BTFLV/PROE_WGR-V/rtl/peripherals/ws2812b.v

`include "../defines.v"
`default_nettype none
`timescale 1ns / 1ns

/**
 * @brief Treibermodul für WS2812B-LEDs (NeoPixel).
 *
 * Dieses Modul steuert eine Kette von WS2812B-LEDs. Es werden nacheinander
 * 24-Bit-Farbwerte (GRB) an die LEDs gesendet. Die Zeitsteuerung erfolgt
 * über entsprechende Zähler (T0H, T0L, T1H, T1L, T_RESET). Dieses Beispiel
 * zeigt eine einfache State-Maschine, die die Daten nacheinander an jede LED
 * überträgt, dann ein Reset-Puls erzeugt und wieder von vorne beginnt.
 *
 * Register-Offsets (jeweils 8 Bit auseinanderliegend):
 * - 0x00: Daten für LED 0
 * - 0x04: Daten für LED 1
 * - 0x08: Daten für LED 2
 * - 0x0C: Daten für LED 3
 * - 0x10: Daten für LED 4
 * - 0x14: Daten für LED 5
 * - 0x18: Daten für LED 6
 * - 0x1C: Daten für LED 7
 *
 * @localparam CLK_PERIOD_NS Zeit pro Takt in Nanosekunden, abgeleitet aus `CLK_FREQ`.
 * @localparam T0H           Länger des "High" bei Bit=0
 * @localparam T0L           Länger des "Low" bei Bit=0
 * @localparam T1H           Länger des "High" bei Bit=1
 * @localparam T1L           Länger des "Low" bei Bit=1
 * @localparam T_RESET       Pause, damit die LED-Kette den Frame erkennt
 *
 * @localparam STATE_LOAD_LED  Initialer Zustand zum Laden der LED-Daten
 * @localparam STATE_SEND_HIGH Sendephase: Leitung auf High
 * @localparam STATE_SEND_LOW  Sendephase: Leitung auf Low
 * @localparam STATE_RESET     Reset-Pause nach allen Bits
 *
 * @input  clk               Systemtakt
 * @input  rst_n             Asynchroner, aktiver-LOW Reset
 * @input  [7:0]  address    Adressoffset, um eine der 8 LED-Daten zu wählen
 * @input  [31:0] write_data Zu schreibender RGB-Wert (24 Bit genutzt)
 * @output [31:0] read_data  Gibt den gespeicherten RGB-Wert zurück
 * @input  we                Write Enable zum Setzen von LED-Farbwerten
 * @input  re                Read Enable zum Auslesen gespeicherter Werte
 *
 * @output reg  ws_out       Ausgangssignal zur WS2812B-Datenleitung
 */

module ws2812b (
  input  wire         clk,
  input  wire         rst_n,
  input  wire  [ 7:0] address,
  input  wire  [31:0] write_data,
  output wire  [31:0] read_data,
  input  wire         we,
  input  wire         re,
  output reg          ws_out
);

  // ---------------------------------------------------------
  // Ermitteln der Taktperiode in Nanosekunden basierend auf CLK_FREQ.
  // Werte T0H, T0L, T1H, T1L, T_RESET werden gerundet (IntegerDivision).
  // ---------------------------------------------------------
  localparam CLK_PERIOD_NS = 1_000_000_000 / `CLK_FREQ;
  localparam T0H     = (400 + CLK_PERIOD_NS - 1) / CLK_PERIOD_NS;
  localparam T0L     = (850 + CLK_PERIOD_NS - 1) / CLK_PERIOD_NS;
  localparam T1H     = (800 + CLK_PERIOD_NS - 1) / CLK_PERIOD_NS;
  localparam T1L     = (450 + CLK_PERIOD_NS - 1) / CLK_PERIOD_NS;
  localparam T_RESET = (50_000 + CLK_PERIOD_NS - 1) / CLK_PERIOD_NS;

  // ---------------------------------------------------------
  // Zustandsdefinitionen
  // ---------------------------------------------------------
  localparam STATE_LOAD_LED   = 2'd0;
  localparam STATE_SEND_HIGH  = 2'd1;
  localparam STATE_SEND_LOW   = 2'd2;
  localparam STATE_RESET      = 2'd3;

  // ---------------------------------------------------------
  // LED-Daten: 8 LEDs à 24 Bit RGB
  // - led_rgb[i] ist ein 24-Bit-Wert, repräsentiert G,R,B
  // - Schieberegister shift_reg zum Senden
  // ---------------------------------------------------------
  reg [23:0] led_rgb [0:7];
  reg [23:0] shift_reg;
  reg [15:0] timer;
  reg [ 4:0] bit_index;
  reg [ 2:0] led_index;
  reg [ 1:0] state;

  // ---------------------------------------------------------
  // Lese-Multiplexer: Bei Adressen 0x00, 0x04, 0x08, ... 0x1C
  // wird der entsprechende led_rgb[i]-Wert (24 Bit) zurückgegeben.
  // Die oberen 8 Bit von read_data bleiben 0.
  // ---------------------------------------------------------
  assign read_data = (address[7:0] == 8'h00) ? {8'b0, led_rgb[0]} :
                     (address[7:0] == 8'h04) ? {8'b0, led_rgb[1]} :
                     (address[7:0] == 8'h08) ? {8'b0, led_rgb[2]} :
                     (address[7:0] == 8'h0C) ? {8'b0, led_rgb[3]} :
                     (address[7:0] == 8'h10) ? {8'b0, led_rgb[4]} :
                     (address[7:0] == 8'h14) ? {8'b0, led_rgb[5]} :
                     (address[7:0] == 8'h18) ? {8'b0, led_rgb[6]} :
                     (address[7:0] == 8'h1C) ? {8'b0, led_rgb[7]} :
                     32'd0;

  // ---------------------------------------------------------
  // Schreiben in die LED-Register
  // - address = 0x00, 0x04, ... => speichert 24 Bit in led_rgb
  // ---------------------------------------------------------
  always @(posedge clk or negedge rst_n)
  begin
    if (!rst_n) 
    begin
      led_rgb[0] <= 24'h0;
      led_rgb[1] <= 24'h0;
      led_rgb[2] <= 24'h0;
      led_rgb[3] <= 24'h0;
      led_rgb[4] <= 24'h0;
      led_rgb[5] <= 24'h0;
      led_rgb[6] <= 24'h0;
      led_rgb[7] <= 24'h0;
    end 
    else if (we) 
    begin
      case(address)
        8'h00: led_rgb[0] <= write_data[23:0];
        8'h04: led_rgb[1] <= write_data[23:0];
        8'h08: led_rgb[2] <= write_data[23:0];
        8'h0C: led_rgb[3] <= write_data[23:0];
        8'h10: led_rgb[4] <= write_data[23:0];
        8'h14: led_rgb[5] <= write_data[23:0];
        8'h18: led_rgb[6] <= write_data[23:0];
        8'h1C: led_rgb[7] <= write_data[23:0];
        default: ;
      endcase
    end
  end

  // ---------------------------------------------------------
  // Haupt-Zustandsmaschine:
  // 1) STATE_LOAD_LED: Lade Daten der aktuellen LED in shift_reg.
  // 2) STATE_SEND_HIGH: Sende "High"-Phase (T0H oder T1H).
  // 3) STATE_SEND_LOW:  Sende "Low"-Phase  (T0L oder T1L).
  // 4) STATE_RESET:     Nach allen Bits die Resetlücke (T_RESET).
  // ---------------------------------------------------------
  always @(posedge clk or negedge rst_n)
  begin
    if (!rst_n)
    begin
      state     <= STATE_LOAD_LED;
      led_index <= 3'd0;
      bit_index <= 5'd23;
      timer     <= 0;
      ws_out    <= 0;
      shift_reg <= 0;
    end
    else
    begin
      case (state)

        STATE_LOAD_LED:
        begin
          shift_reg <= {led_rgb[led_index][23:16], led_rgb[led_index][15:8], led_rgb[led_index][7:0]};
          bit_index <= 23;

          if (shift_reg[23]) begin
            timer <= T1H - 1;
          end else begin
            timer <= T0H - 1;
          end

          ws_out <= 1;
          state  <= STATE_SEND_HIGH;
        end

        STATE_SEND_HIGH:
        begin
          if (timer == 0) begin
            timer <= shift_reg[bit_index] ? (T1L - 1) : (T0L - 1);
            ws_out <= 0;
            state <= STATE_SEND_LOW;
          end else begin
            timer <= timer - 1;
          end
        end

        STATE_SEND_LOW:
        begin
          if (timer == 0) begin
            if (bit_index == 0) begin
              if (led_index == 7) begin
                timer <= T_RESET - 1;
                state <= STATE_RESET;
              end else begin
                led_index <= led_index + 1;
                state <= STATE_LOAD_LED;
              end
            end else begin
              bit_index <= bit_index - 1;
              timer <= shift_reg[bit_index - 1] ? (T1H - 1) : (T0H - 1);
              ws_out <= 1;
              state <= STATE_SEND_HIGH;
            end
          end else begin
            timer <= timer - 1;
          end
        end

        STATE_RESET:
        begin
          if (timer == 0) begin
            led_index <= 0;
            state <= STATE_LOAD_LED;
          end else begin
            timer <= timer - 1;
          end
        end

        default: state <= STATE_LOAD_LED;

      endcase
    end
  end

endmodule
