BTFLV/PROE_WGR-V/(commit log)

2025-03-12 Initial Commit
    Wir gehen rein
2025-03-13 C Änderungen und Readme
2025-03-22 Full Documentation Pipeline (wir gehen rein)
2025-03-22 need bed
2025-03-24 comment pwm_timer.v
